callestahl/examensarbete/hardware/README.md

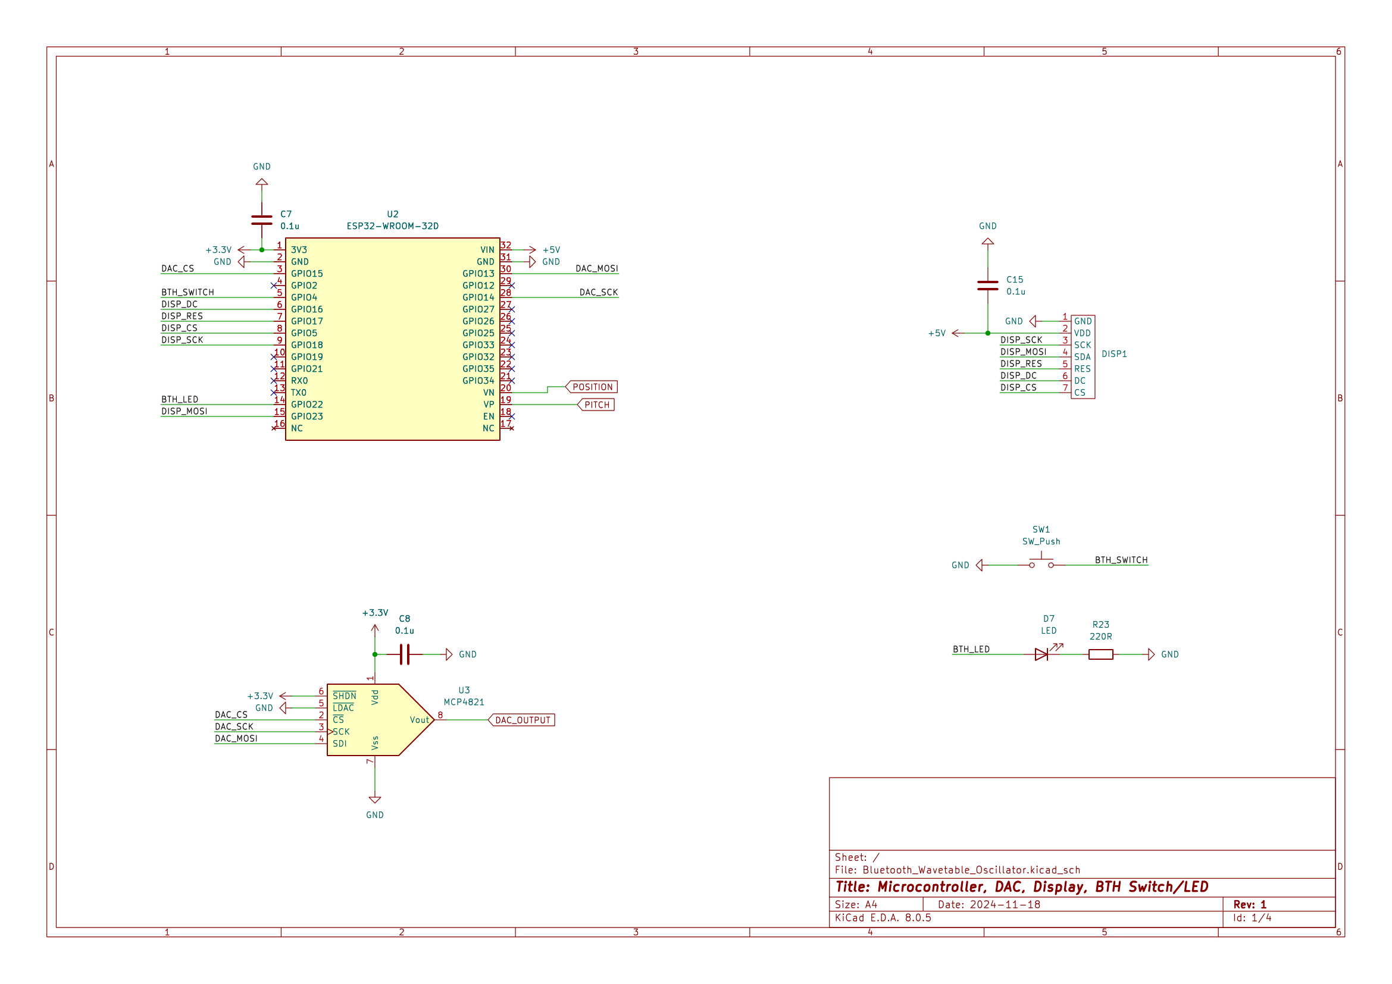
[picture p1: hardware/schematic_png/Bluetooth_Wavetable_Oscillator-1.png]

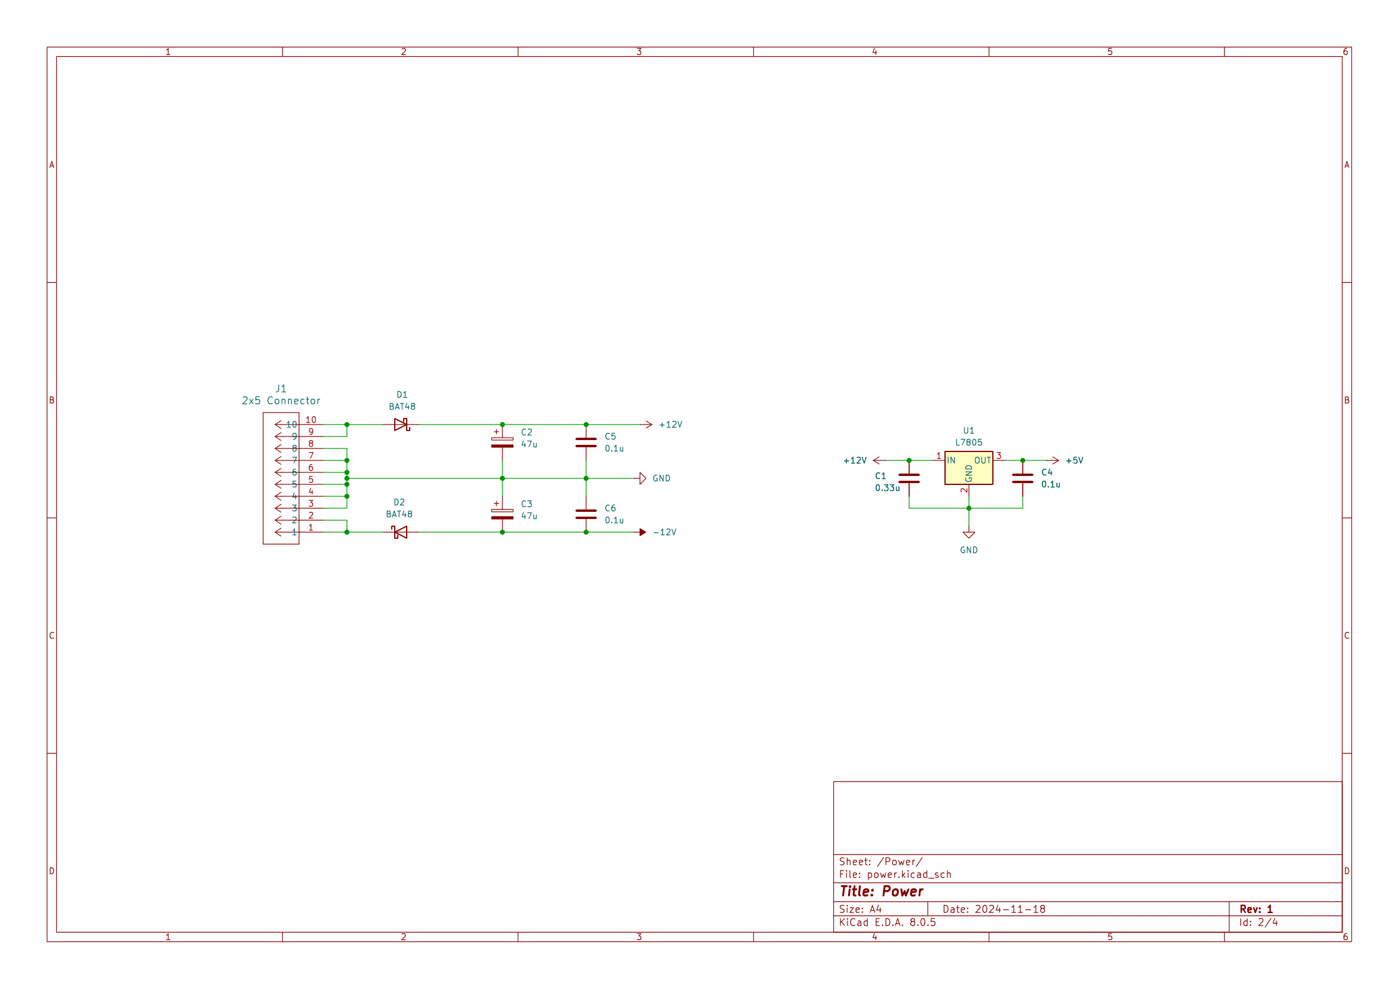
[picture p2: hardware/schematic_png/Bluetooth_Wavetable_Oscillator-2.png]

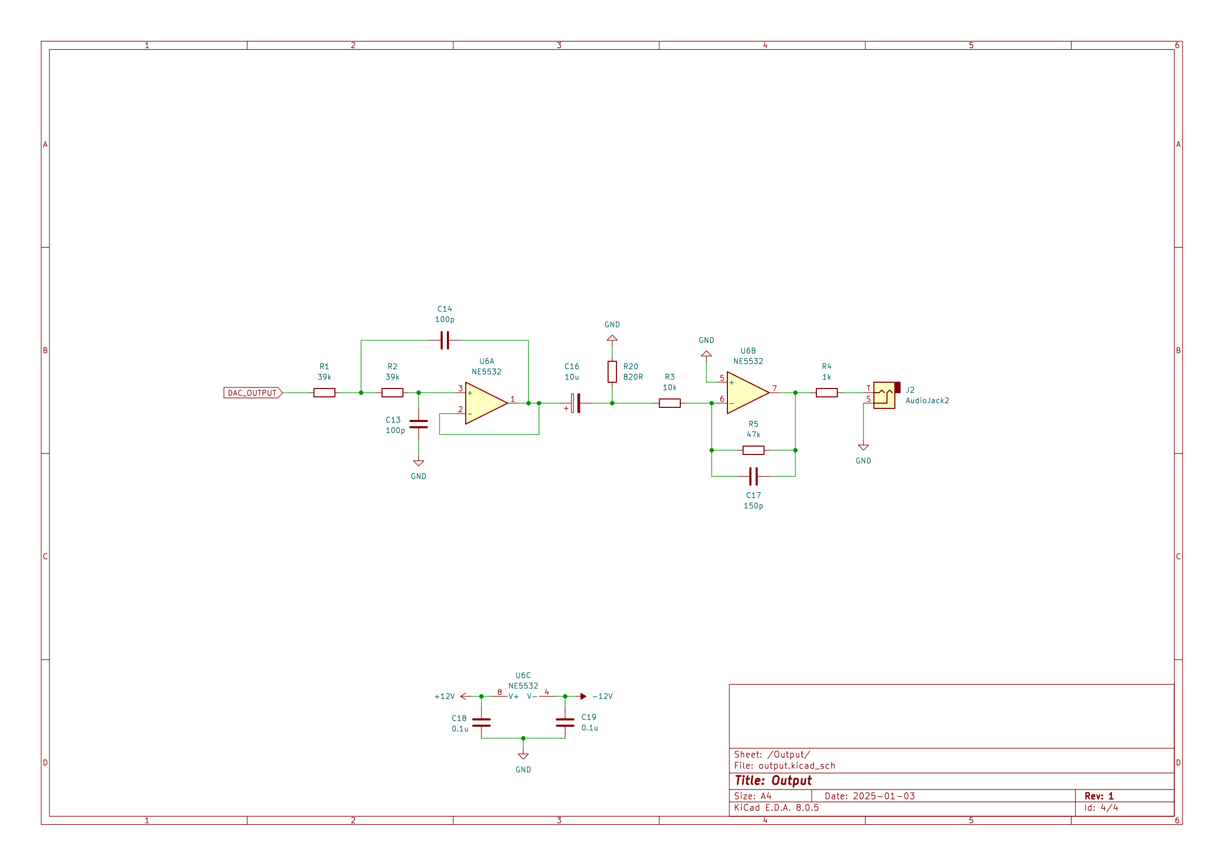
[picture p3: hardware/schematic_png/Bluetooth_Wavetable_Oscillator-3.png]

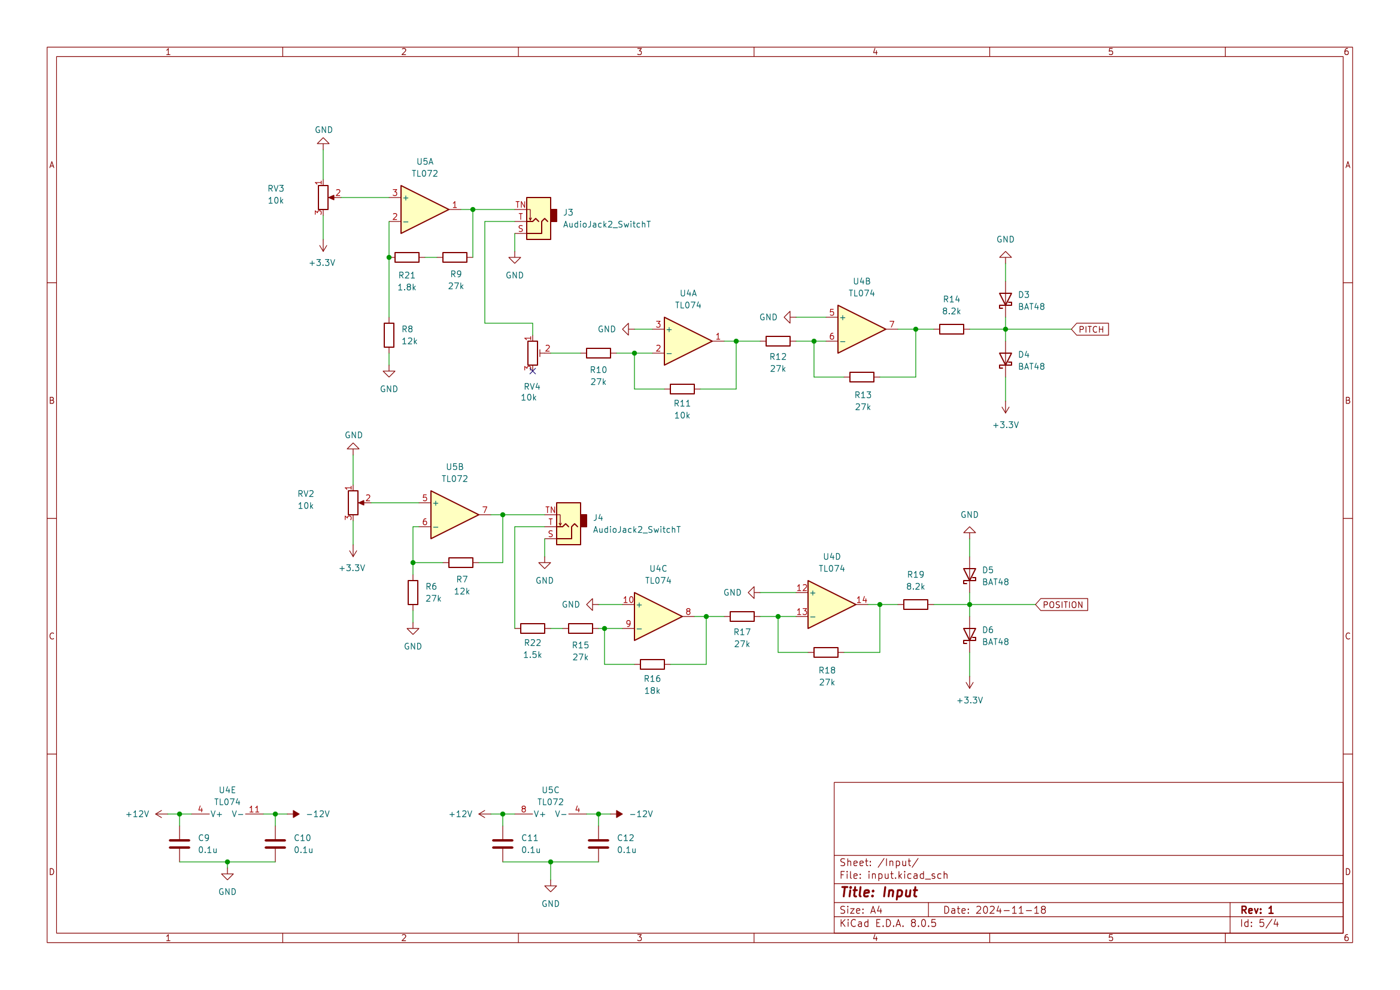
[picture p4: hardware/schematic_png/Bluetooth_Wavetable_Oscillator-4.png]
