callestahl/examensarbete/hardware/Bluetooth_Wavetable_Oscillator.pdf

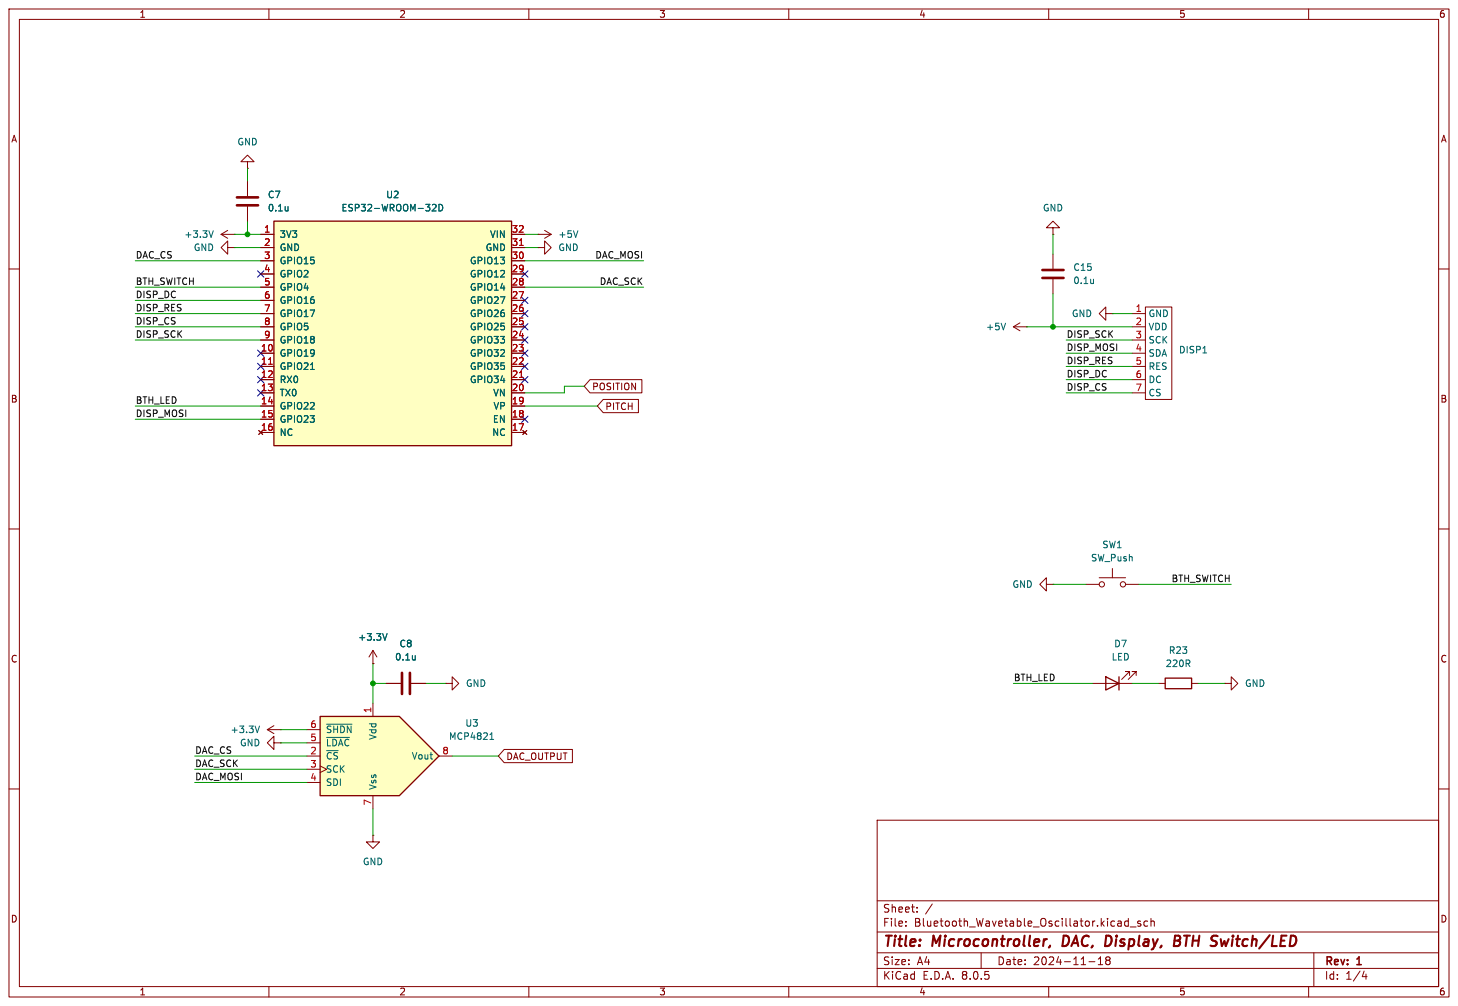
[picture p5: page 1]

Output File: output.kicad_sch GND

1 ~{CS} 2 SCK 3 SDI 4 ~{LDAC} 5 ~{SHDN} 6 Vss 7 Vout 8 U3 MCP4821 GND

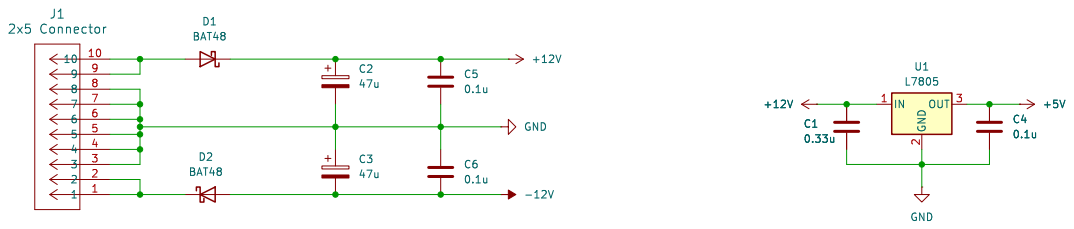
[picture p6: page 2]

Id: 2/4 Title: Power File: power.kicad_sch Sheet: /Power/

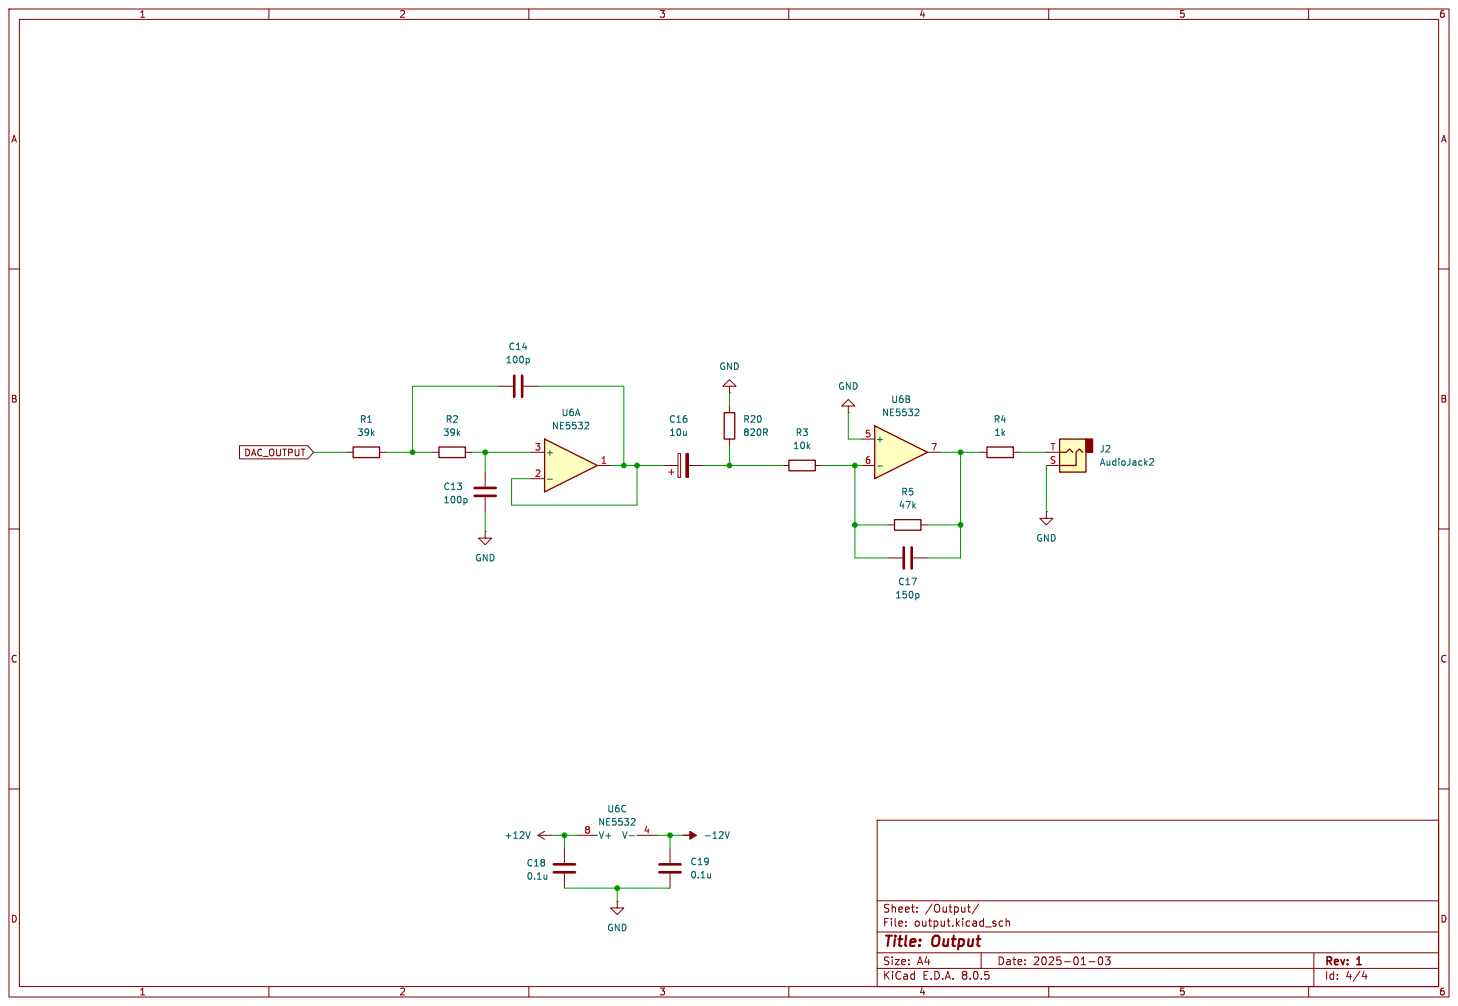
[picture p7: page 3]

Id: 4/4 Title: Output File: output.kicad_sch Sheet: /Output/

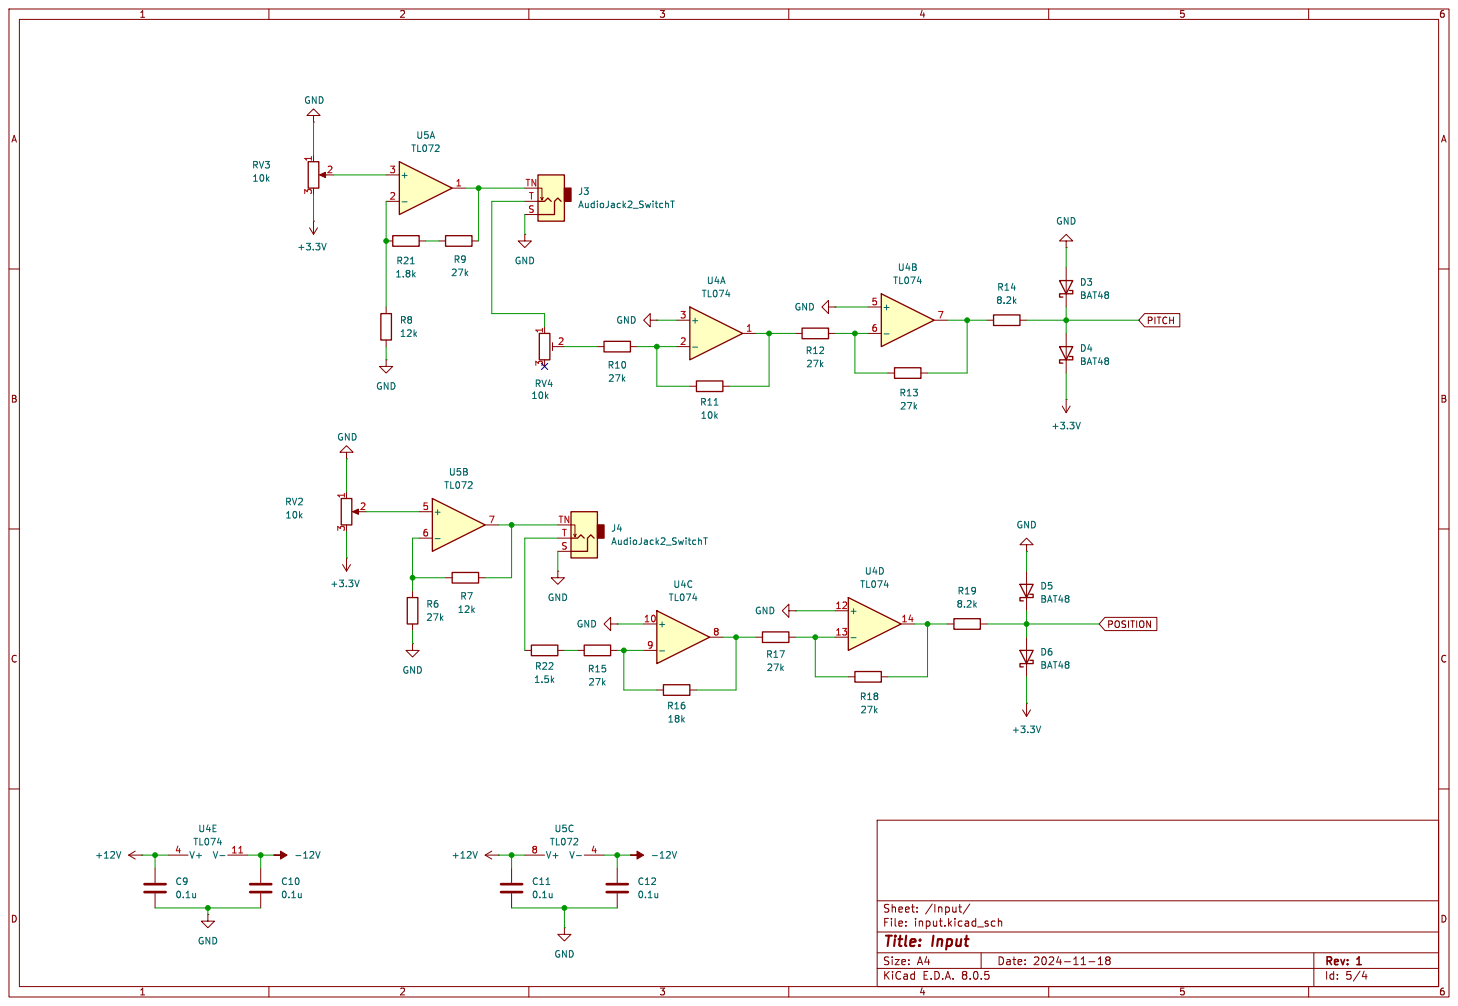
[picture p8: page 4]

Id: 5/4 Title: Input File: input.kicad_sch Sheet: /Input/ C9
