callestahl/examensarbete/hardware/Bluetooth_Wavetable_Oscillator/Bluetooth_Wavetable_Oscillator.kicad_pcb

## KiCad design hardware/Bluetooth_Wavetable_Oscillator/Bluetooth_Wavetable_Oscillator.kicad_pcb (2024-12-09)

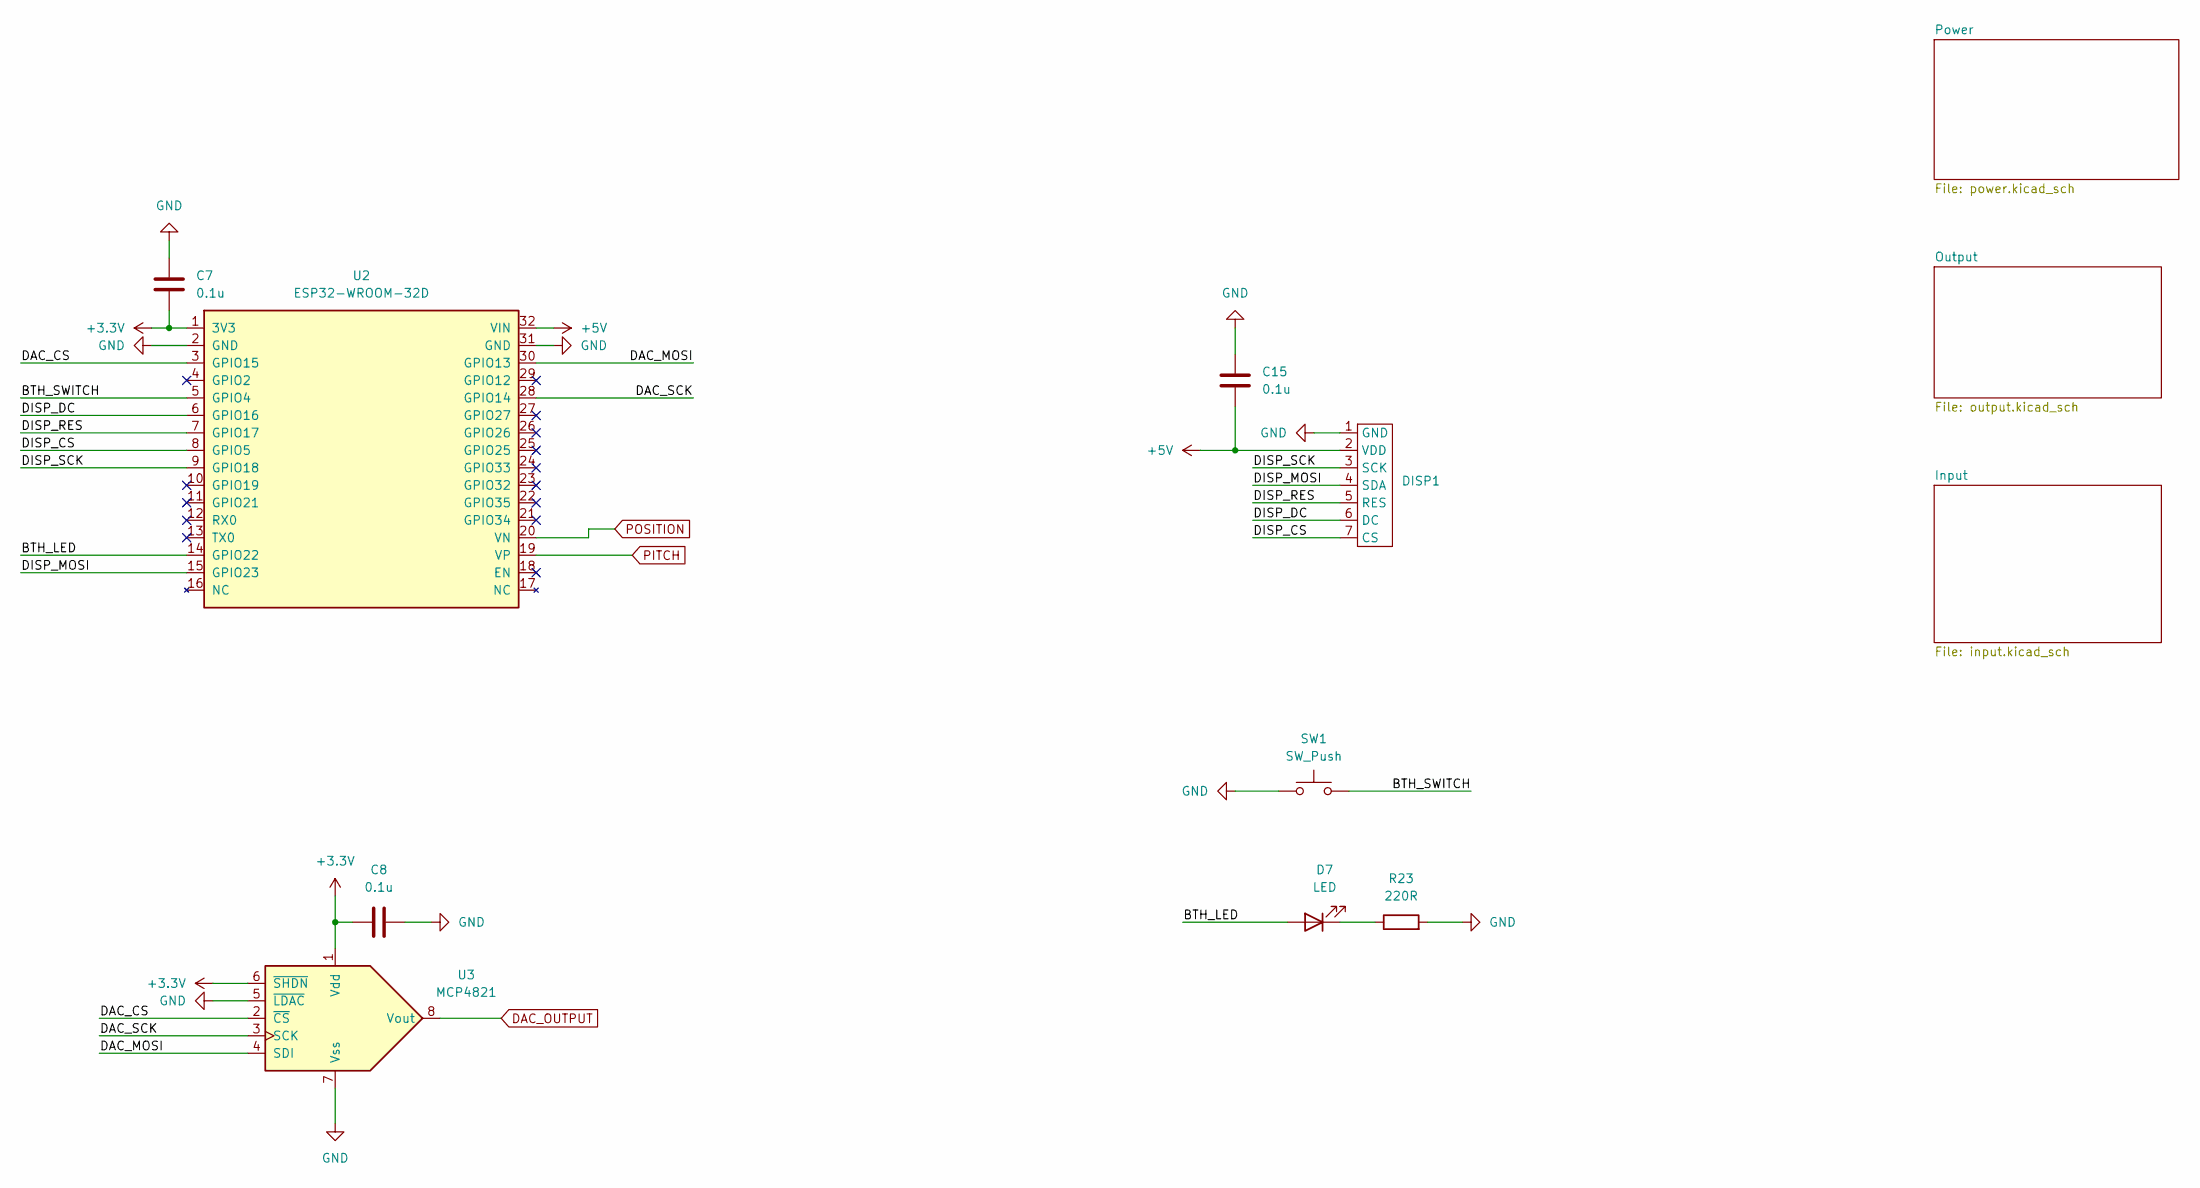
[picture p9: schematic Bluetooth_Wavetable_Oscillator.kicad_sch, Microcontroller, DAC, Display, BTH Switch/LED]

Parts:
C7, C8, C15: 0.1u; C_Disc_D5.0mm_W2.5mm_P5.00mm
D7: LED; D_A-405_P2.54mm_Vertical_AnodeUp
DISP1: 1.5inch_RGB_OLED_Module
R23: 220R; R_Axial_DIN0204_L3.6mm_D1.6mm_P2.54mm_Vertical
SW1: SW_Push; 6Pin-Switch-Button
U2: ESP32-WROOM-32D; ESP32
U3: MCP4821; DIP-8_W7.62mm

Connections:
+3.3V: C7.2, C8.1, U2.1 (3V3), U3.1 (Vdd), U3.6 (~SHDN); also elsewhere on the board
+5V: C15.2, DISP1.2 (VDD), U2.32 (VIN); also elsewhere on the board
/BTH_LED: D7.2 (A), U2.14 (GPIO22)
/BTH_SWITCH: SW1.2, U2.5 (GPIO4)
/DAC_CS: U2.3 (GPIO15), U3.2 (~CS)
/DAC_MOSI: U2.30 (GPIO13), U3.4 (SDI)
/DAC_SCK: U2.28 (GPIO14), U3.3 (SCK)
/DISP_CS: DISP1.7 (CS), U2.8 (GPIO5)
/DISP_DC: DISP1.6 (DC), U2.6 (GPIO16)
/DISP_MOSI: DISP1.4 (SDA), U2.15 (GPIO23)
/DISP_RES: DISP1.5 (RES), U2.7 (GPIO17)
/DISP_SCK: DISP1.3 (SCK), U2.9 (GPIO18)
DAC_OUTPUT: U3.8 (Vout); also elsewhere on the board
GND: C7.1, C8.2, C15.1, DISP1.1 (GND), R23.2, SW1.1, U2.2 (GND), U2.31 (GND), U3.5 (~LDAC), U3.7 (Vss); also elsewhere on the board
unnamed: D7.1 (K), R23.1
PITCH: U2.19 (VP); also elsewhere on the board
POSITION: U2.20 (VN); also elsewhere on the board

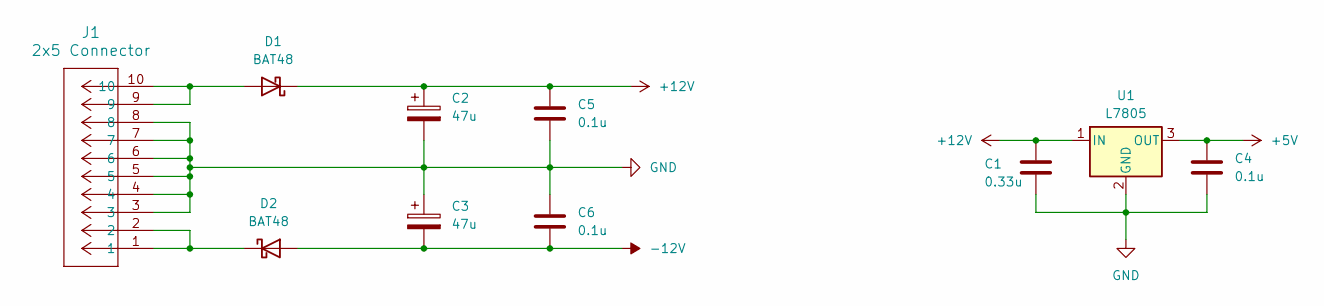
[picture p10: schematic power.kicad_sch]

Parts:
C1: 0.33u; C_Disc_D5.0mm_W2.5mm_P5.00mm
C2, C3: 47u; CP_Radial_D5.0mm_P2.50mm
C4, C5, C6: 0.1u; C_Disc_D5.0mm_W2.5mm_P5.00mm
D1, D2: BAT48; D_DO-35_SOD27_P2.54mm_Vertical_KathodeUp
J1: 2x5 Connector; 10_pin_eurorack_connector
U1: L7805; TO-220-3_Horizontal_TabDown

Connections:
+5V: C4.1, U1.3 (OUT); also elsewhere on the board
+12V: C1.1, C2.1, C5.1, D1.1 (K), U1.1 (IN); also elsewhere on the board
-12V: C3.2, C6.2, D2.2 (A); also elsewhere on the board
GND: C1.2, C2.2, C3.1, C4.2, C5.2, C6.1, J1.3, J1.4, J1.5, J1.6, J1.7, J1.8, U1.2 (GND); also elsewhere on the board
unnamed: D1.2 (A), J1.9, J1.10
unnamed: D2.1 (K), J1.1, J1.2

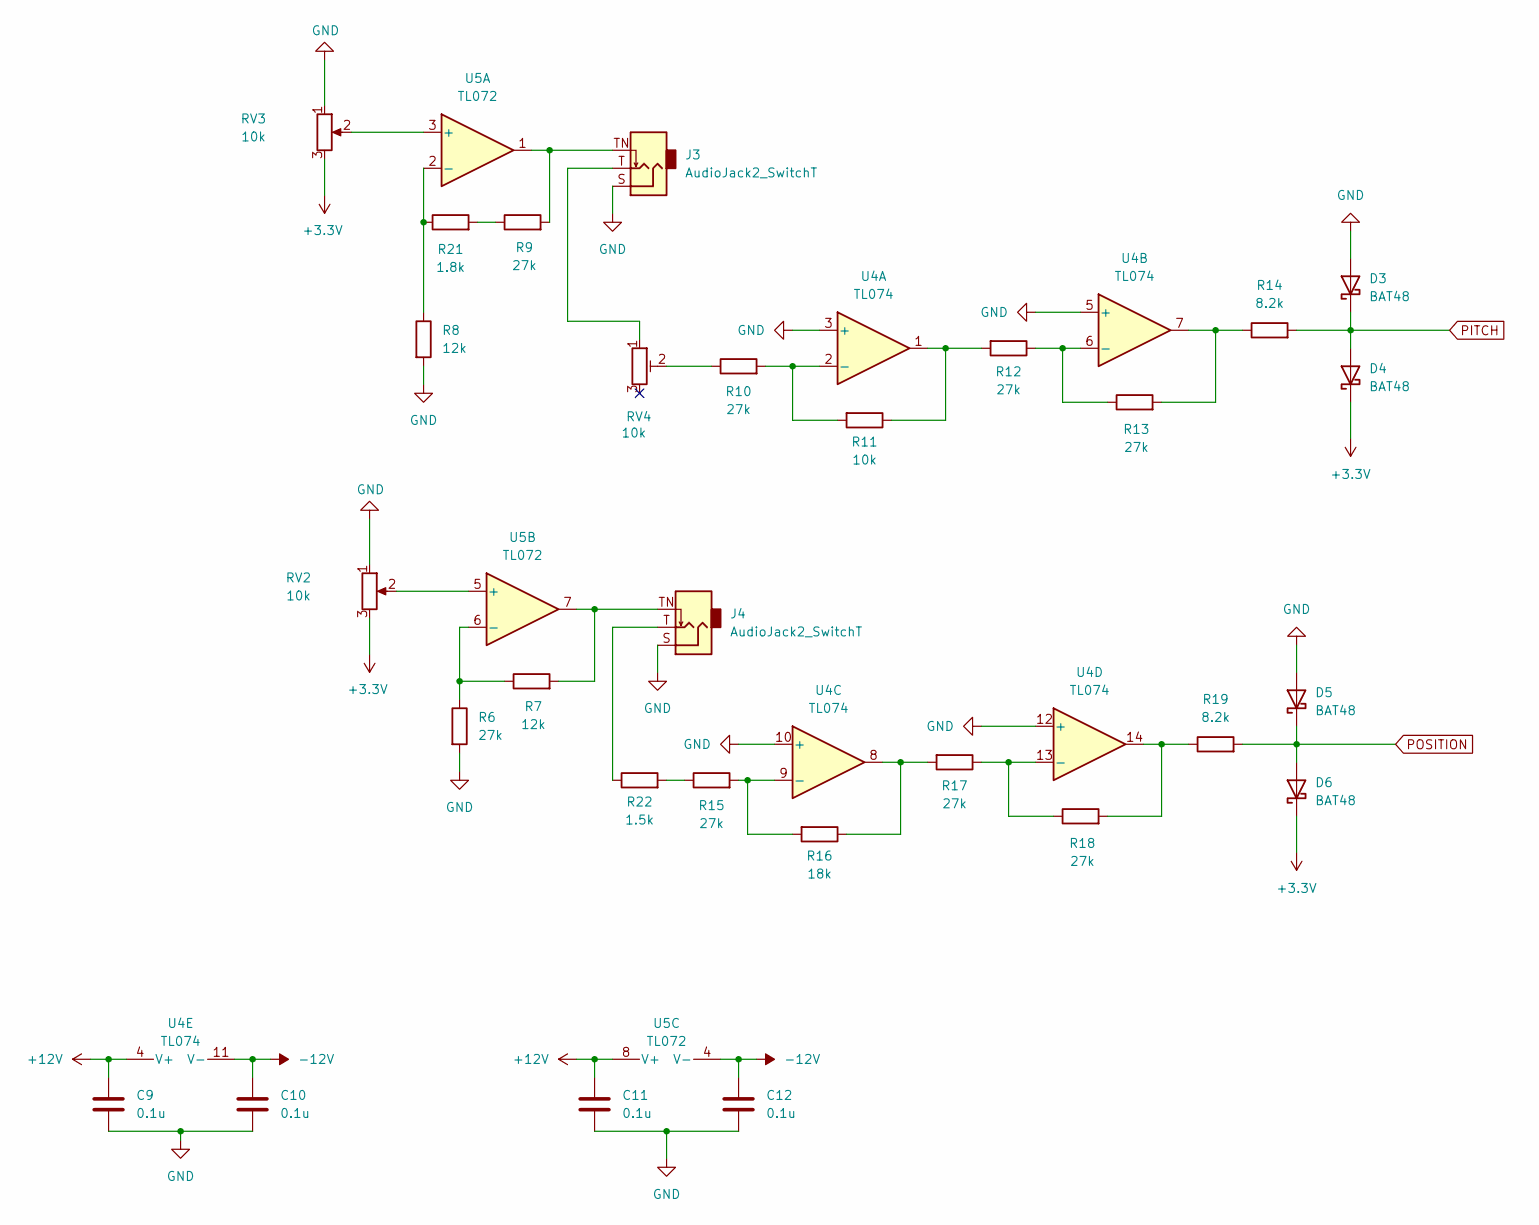
[picture p11: schematic input.kicad_sch]

Parts:
C9, C10, C11, C12: 0.1u; C_Disc_D5.0mm_W2.5mm_P5.00mm
D3, D4, D5, D6: BAT48; D_DO-34_SOD68_P7.62mm_Horizontal
J3, J4: AudioJack2_SwitchT; Jack_3.5mm_QingPu_WQP-PJ398SM_Vertical_CircularHoles
R6: 27k; R_Axial_DIN0204_L3.6mm_D1.6mm_P7.62mm_Horizontal
R7: 12k; R_Axial_DIN0204_L3.6mm_D1.6mm_P7.62mm_Horizontal
R8: 12k; R_Axial_DIN0204_L3.6mm_D1.6mm_P2.54mm_Vertical
R9, R10, R12, R13, R15, R17, R18: 27k; R_Axial_DIN0204_L3.6mm_D1.6mm_P2.54mm_Vertical
R11: 10k; R_Axial_DIN0204_L3.6mm_D1.6mm_P2.54mm_Vertical
R14, R19: 8.2k; R_Axial_DIN0204_L3.6mm_D1.6mm_P2.54mm_Vertical
R16: 18k; R_Axial_DIN0204_L3.6mm_D1.6mm_P2.54mm_Vertical
R21: 1.8k; R_Axial_DIN0204_L3.6mm_D1.6mm_P2.54mm_Vertical
R22: 1.5k; R_Axial_DIN0204_L3.6mm_D1.6mm_P2.54mm_Vertical
RV2, RV3: 10k; Potentiometer_Bourns_PTV09A-1_Single_Vertical
RV4: 10k; Trimmer-potentiometer
U4: TL074; DIP-14_W7.62mm
U5: TL072; DIP-8_W7.62mm

Connections:
+3.3V: D4.1 (K), D6.1 (K), RV2.3, RV3.3; also elsewhere on the board
+12V: C9.1, C11.1, U4.4 (V+), U5.8 (V+); also elsewhere on the board
-12V: C10.1, C12.1, U4.11 (V-), U5.4 (V-); also elsewhere on the board
GND: C9.2, C10.2, C11.2, C12.2, D3.2 (A), D5.2 (A), J3.S, J4.S, R6.2, R8.2, RV2.1, RV3.1, U4.3 (+), U4.5 (+), U4.10 (+), U4.12 (+); also elsewhere on the board
unnamed: J3.T, RV4.1
unnamed: J3.TN, R9.2, U5.1
unnamed: J4.T, R22.1
unnamed: J4.TN, R7.2, U5.7
unnamed: R10.1, RV4.2
unnamed: R11.1, R12.2, U4.1
unnamed: R13.2, R14.1, U4.7
unnamed: R15.1, R22.2
unnamed: R16.1, R17.2, U4.8
unnamed: R18.2, R19.1, U4.14
unnamed: R9.1, R21.2
unnamed: R10.2, R11.2, U4.2 (-)
unnamed: R12.1, R13.1, U4.6 (-)
unnamed: R15.2, R16.2, U4.9 (-)
unnamed: R17.1, R18.1, U4.13 (-)
unnamed: RV3.2, U5.3 (+)
unnamed: R8.1, R21.1, U5.2 (-)
unnamed: RV2.2, U5.5 (+)
unnamed: R6.1, R7.1, U5.6 (-)
PITCH: D3.1 (K), D4.2 (A), R14.2; also elsewhere on the board
POSITION: D5.1 (K), D6.2 (A), R19.2; also elsewhere on the board

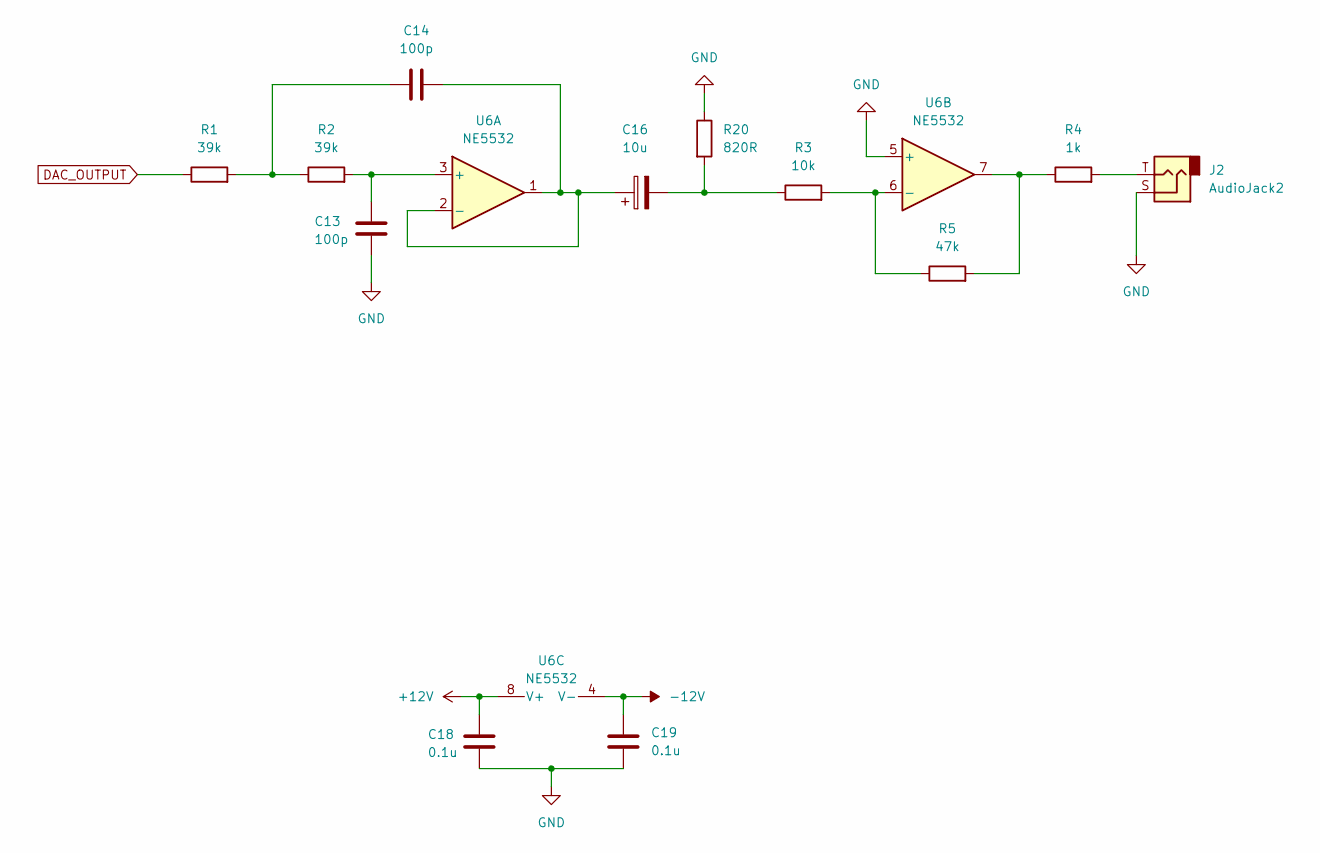
[picture p12: schematic output.kicad_sch]

Parts:
C13, C14: 100p; C_Disc_D5.0mm_W2.5mm_P5.00mm
C16: 10u; CP_Radial_D5.0mm_P2.50mm
C18, C19: 0.1u; C_Disc_D5.0mm_W2.5mm_P5.00mm
J2: AudioJack2; Jack_3.5mm_QingPu_WQP-PJ398SM_Vertical_CircularHoles
R1, R2: 39k; R_Axial_DIN0204_L3.6mm_D1.6mm_P7.62mm_Horizontal
R3: 10k; R_Axial_DIN0204_L3.6mm_D1.6mm_P7.62mm_Horizontal
R4: 1k; R_Axial_DIN0204_L3.6mm_D1.6mm_P7.62mm_Horizontal
R5: 47k; R_Axial_DIN0204_L3.6mm_D1.6mm_P7.62mm_Horizontal
R20: 820R; R_Axial_DIN0204_L3.6mm_D1.6mm_P7.62mm_Horizontal
U6: NE5532; DIP-8_W7.62mm

Connections:
+12V: C18.1, U6.8 (V+); also elsewhere on the board
-12V: C19.1, U6.4 (V-); also elsewhere on the board
DAC_OUTPUT: R1.1; also elsewhere on the board
GND: C13.2, C18.2, C19.2, J2.S, R20.1, U6.5 (+); also elsewhere on the board
unnamed: C14.2, R1.2, R2.1
unnamed: C16.2, R3.1, R20.2
unnamed: J2.T, R4.2
unnamed: R4.1, R5.2, U6.7
unnamed: C13.1, R2.2, U6.3 (+)
unnamed: C14.1, C16.1, U6.1, U6.2 (-)
unnamed: R3.2, R5.1, U6.6 (-)

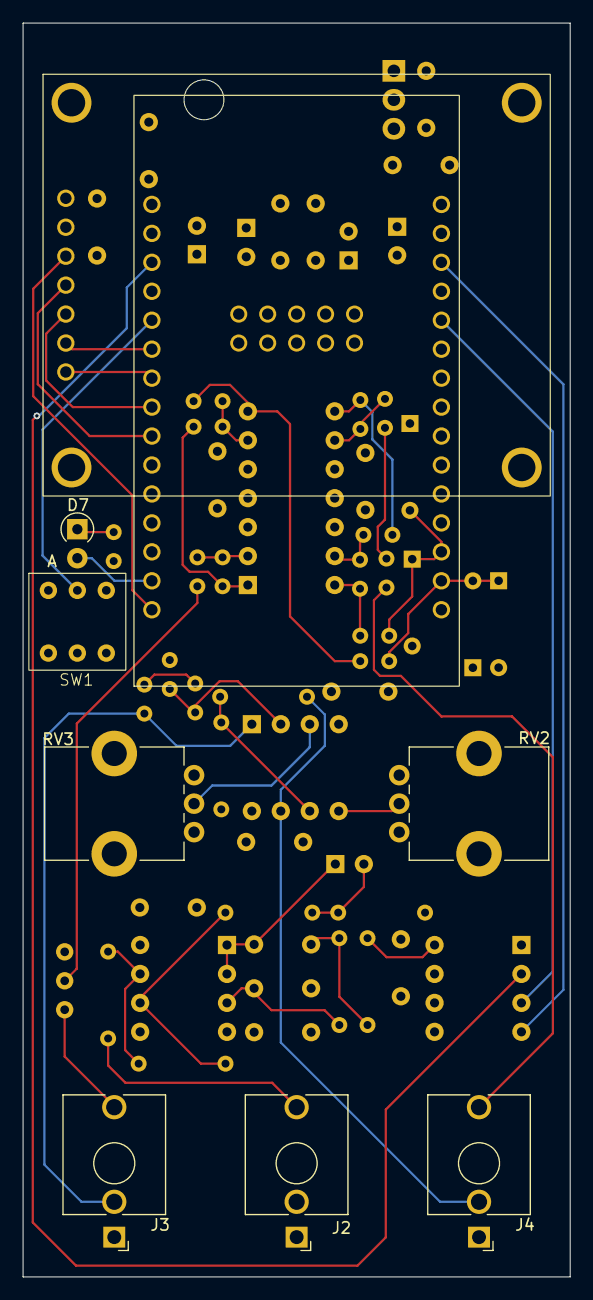
[picture p13: board Bluetooth_Wavetable_Oscillator.kicad_pcb from above]

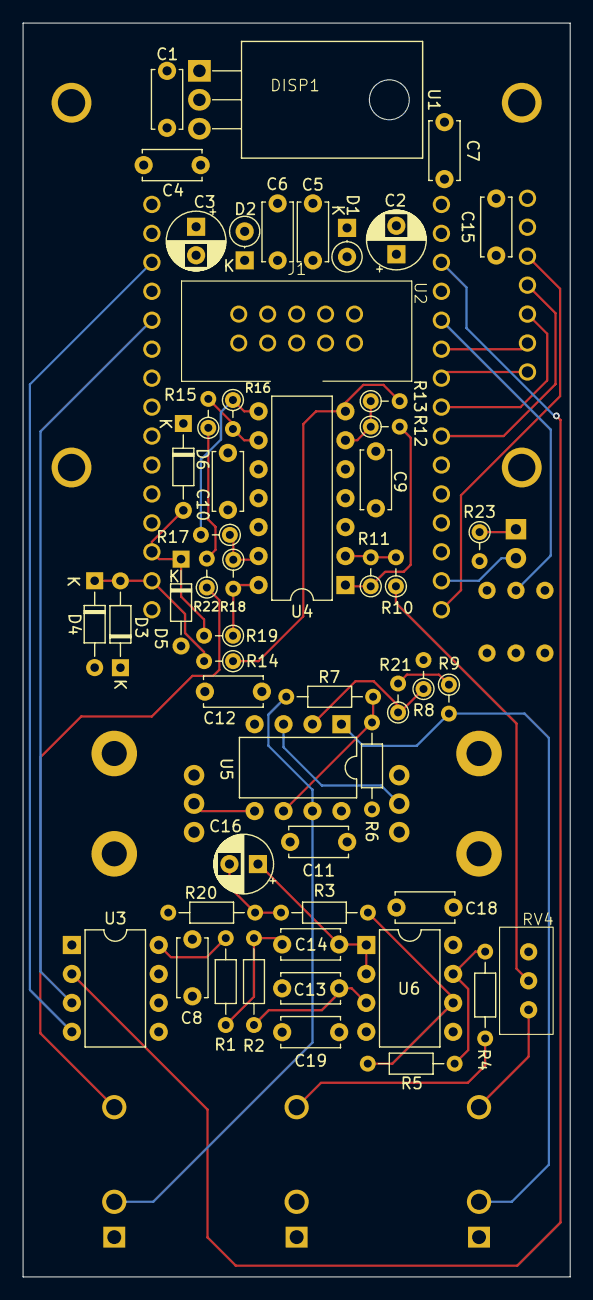
[picture p14: board Bluetooth_Wavetable_Oscillator.kicad_pcb from below]

Board: 4 copper layers, 48.0 x 110.0 mm, 63 parts (54 on the bottom side), 47 nets.
