callestahl/examensarbete/esp32/spp_application/spp.cpp

#include "spp.h"
#include "define.h"
#include "bluetooth.h"

#include "BluetoothSerial.h"
#include <Adafruit_GFX.h>
#include <Adafruit_SSD1351.h>

#define BLUETOOTH_FINISHED_CODE 0x06
#define BLUETOOTH_ACKNOWLEDGE_CODE 0x08
#define BLUETOOTH_ERROR_CODE 0x10

struct BluetoothHeader
{
    uint16_t id0;
    uint16_t id1;
    uint16_t id2;
    uint16_t id3;
    uint16_t cycle_sample_count;
    uint16_t total_bytes_to_receive_high;
    uint16_t total_bytes_to_receive_low;
};

struct SPP
{
    BluetoothSerial bluetooth_serial;
    Bluetooth bluetooth;
    QueueHandle_t queue;
    TaskHandle_t* task_notification_handle;

    bool initialized;
    uint32_t bytes_received;
    uint32_t bytes_to_received;
    uint32_t queue_size;
    uint64_t last_read_value_time;
    uint64_t time_before_reset;
};

global WaveTableOscillator* g_temp_osci = NULL;
global SPP g_spp;
global uint32_t g_chunk_bytes = 0;

internal uint8_t spp_read(void)
{
    uint8_t value = 0;
    if (xQueueReceive(g_spp.queue, &value, 0))
    {
        return value;
    }
    return 0;
}

internal int spp_data_in_queue(void)
{
    return uxQueueMessagesWaiting(g_spp.queue);
}

internal void spp_clear_queue()
{
    while (spp_data_in_queue())
    {
        spp_read();
    }
}

internal bool spp_has_timed_out(uint64_t start_time, uint64_t time_to_timeout)
{
    if ((millis() - start_time) > time_to_timeout)
    {
        g_chunk_bytes = 0;
        g_spp.bytes_received = 0;
        g_spp.bytes_to_received = 0;
        bluetooth_reset(&g_spp.bluetooth);
        spp_clear_queue();
        g_spp.bluetooth_serial.write(BLUETOOTH_ERROR_CODE);
        return true;
    }
    return false;
}

internal uint16_t spp_get_uint16()
{
    g_chunk_bytes += 2;
    g_spp.bytes_received += 2;
    uint8_t high = spp_read();
    uint8_t low = spp_read();
    return ((uint16_t)high << 8) | ((uint16_t)low);
}

internal void spp_revert_transaction()
{
    g_chunk_bytes = 0;
    g_spp.bytes_received = 0;
    g_spp.bytes_to_received = 0;
    bluetooth_reset(&g_spp.bluetooth);
    spp_clear_queue();
    g_spp.bluetooth_serial.write(BLUETOOTH_ERROR_CODE);
}

internal bool spp_read_header()
{
    g_chunk_bytes = 0;
    g_spp.bytes_received = 0;
    uint16_t id0 = spp_get_uint16();
    uint16_t id1 = spp_get_uint16();
    uint16_t id2 = spp_get_uint16();
    uint16_t id3 = spp_get_uint16();
    if (id0 == 29960 && id1 == 62903 && id2 == 35185 && id3 == 26662)
    {
        uint16_t cycle_sample_count = spp_get_uint16();
        if (g_temp_osci->total_cycles)
        {
            wave_table_oscilator_clean(g_temp_osci);
        }
        g_temp_osci->samples_per_cycle = cycle_sample_count;
        g_temp_osci->total_cycles = 0;
        g_spp.bluetooth.header_read = true;
        g_spp.bluetooth.table_index = 0;
        g_spp.bluetooth.sample_index = 0;

        uint16_t bytes_to_received_high = spp_get_uint16();
        uint16_t bytes_to_received_low = spp_get_uint16();
        g_spp.bytes_to_received = ((uint32_t)bytes_to_received_high << 16) |
                                  (uint32_t)bytes_to_received_low;

        // g_spp.bluetooth_serial.write(BLUETOOTH_ACKNOWLEDGE_CODE);
    }
    else
    {
        spp_revert_transaction();
        return false;
    }
    return true;
}

internal uint16_t spp_sample_key(uint16_t key)
{
    key = ~key + (key << 15);
    key = key ^ (key >> 12);
    key = key + (key << 2);
    key = key ^ (key >> 4);
    key = key * 2057;
    key = key ^ (key >> 16);
    return key;
}

global uint32_t te = 0;

internal bool spp_process_sample()
{
    // uint16_t key = spp_get_uint16();
    uint16_t sample = spp_get_uint16();
    // if (key == spp_sample_key(sample))
    {
        BluetoothSampleProcessCode code =
            bluetooth_process_sample(&g_spp.bluetooth, sample, g_temp_osci);
        if (code == SAMPLE_PROCESS_ERROR)
        {
            return false;
        }
        else if (g_chunk_bytes == g_spp.queue_size)
        {
            g_spp.bluetooth_serial.write(BLUETOOTH_ACKNOWLEDGE_CODE);
            g_chunk_bytes = 0;
        }
        return true;
    }
    // return false;
}

void on_spp_data_receive_cb(const uint8_t* data, size_t size)
{
    for (size_t i = 0; i < size; ++i)
    {
        xQueueSend(g_spp.queue, data + i, (TickType_t)0);
    }
    if (*g_spp.task_notification_handle != NULL)
    {
        xTaskNotifyGive(*g_spp.task_notification_handle);
    }
}

void spp_setup(TaskHandle_t* task_notification_handle, uint32_t queue_size)
{
    if (!g_spp.initialized)
    {
        g_spp.task_notification_handle = task_notification_handle;
        g_spp.queue_size = queue_size;
        g_spp.queue = xQueueCreate(queue_size, sizeof(uint8_t));
        g_spp.initialized = true;
        g_spp.time_before_reset = 500;
#if 0
        g_temp_osci.tables_capacity = 256;
        g_temp_osci.tables =
            (WaveTable*)calloc(g_temp_osci.tables_capacity, sizeof(WaveTable));
#endif
    }
    else
    {
        // TODO(Linus): Logging
    }
}

void spp_begin(const char* name)
{
    g_spp.bluetooth_serial.begin(name, false, true);
    g_spp.bluetooth_serial.enableSSP();
    g_spp.bluetooth_serial.onData(on_spp_data_receive_cb);
}

void spp_end(void)
{
    g_spp.bluetooth_serial.end();
    g_spp.bluetooth_serial.disableSSP();
}

BluetoothCode spp_is_complete()
{

    if (g_spp.bluetooth.reading_samples)
    {
        if (spp_has_timed_out(g_spp.last_read_value_time,
                              g_spp.time_before_reset))
        {
            return BLUETOOTH_ERROR;
        }
        if (g_spp.bytes_received == g_spp.bytes_to_received)
        {
            g_chunk_bytes = 0;
            g_spp.bytes_received = 0;
            g_spp.bytes_to_received = 0;
            bluetooth_reset(&g_spp.bluetooth);
            g_spp.bluetooth_serial.write(BLUETOOTH_FINISHED_CODE);
            if (g_temp_osci->total_cycles > 0)
            {
#if 0
                if (xSemaphoreTake(mutex, portMAX_DELAY))
                {
                    if (xSemaphoreTake(mutex_screen, portMAX_DELAY))
                    {
                        wave_table_oscilator_clean(oscillator);
                        WaveTableOscillator temp = *oscillator;
                        *oscillator = g_temp_osci;
                        g_temp_osci = temp;
                        xSemaphoreGive(mutex_screen);
                    }
                    xSemaphoreGive(mutex);
                }
#endif
                return BLUETOOTH_DONE;
            }
        }
    }
    return BLUETOOTH_OK;
}

BluetoothCode spp_look_for_incoming_messages(WaveTableOscillator* oscillator)

{
    const uint64_t start_time = millis();
    const uint64_t time_to_timeout = 500;

    g_temp_osci = oscillator;

    while (spp_data_in_queue())
    {
        if (spp_has_timed_out(start_time, time_to_timeout))
        {
            return BLUETOOTH_ERROR;
        }
        if (!g_spp.bluetooth.header_read)
        {
            if (spp_data_in_queue() >= sizeof(BluetoothHeader))
            {
                if (!spp_read_header())
                {
                    return BLUETOOTH_ERROR;
                }
            }
        }
        else
        {
            if (spp_data_in_queue() >= 2)
            {
                if (!spp_process_sample())
                {
                    spp_revert_transaction();
                    return BLUETOOTH_ERROR;
                }
            }
            g_spp.bluetooth.reading_samples = true;
        }
        g_spp.last_read_value_time = millis();
    }
    return spp_is_complete();
}
