callestahl/examensarbete/(commit log)

2024-11-06 Ported code from pico to esp32
2024-11-07 add analog to pitch function
2024-11-08 Skuff impl, cycle sample count calculation
2024-11-09 Cycles to device bluetooth logic working
2024-11-14 More refactoring and bug fix
    [application.cpp, spp.cpp, wave_table.cpp]
2024-11-14 add kicad project
    [Bluetooth_Wavetable_Oscillator.kicad_pcb, Bluetooth_Wavetable_Oscillator.kicad_sch]
2024-11-18 first schematic
    [Bluetooth_Wavetable_Oscillator.kicad_pcb, Bluetooth_Wavetable_Oscillator.kicad_sch, input.kicad_sch, output.kicad_sch, power.kicad_sch]
2024-11-21 bluetooth logic in seperate task, mutex on oscillator writes, notify task to run
    [application.cpp, main.cpp, spp.cpp, spp.h]
2024-11-22 comment out buggy algorithm
    [application.cpp, audio_processing.cpp, audio_processing.h, main.cpp, spp.cpp, spp.h]
2024-11-25 add audio test files
    [Bluetooth_Wavetable_Oscillator.kicad_pcb, Bluetooth_Wavetable_Oscillator.kicad_sch, input.kicad_sch, output.kicad_sch, power.kicad_sch]
2024-11-25 change ADC input pins in schematic
    [Bluetooth_Wavetable_Oscillator.kicad_sch]
2024-11-28 add bth components, add component values, update SPI pins, change disp power supply to 5V
    [Bluetooth_Wavetable_Oscillator.kicad_sch, input.kicad_sch, output.kicad_sch, power.kicad_sch]
2024-11-28 Bluetooth on by button click
2024-11-29 start PCB layout
    [Bluetooth_Wavetable_Oscillator.kicad_pcb, Bluetooth_Wavetable_Oscillator.kicad_sch, input.kicad_sch, output.kicad_sch]
2024-11-29 add kicad libraries
    [Bluetooth_Wavetable_Oscillator.kicad_pcb]
2024-12-02 update esp32 footprint
    [Bluetooth_Wavetable_Oscillator.kicad_pcb]
2024-12-02 update shematic, PCB and footprints
    [Bluetooth_Wavetable_Oscillator.kicad_pcb, input.kicad_sch, output.kicad_sch, power.kicad_sch]
2024-12-09 all items connected
    [Bluetooth_Wavetable_Oscillator.kicad_pcb, input.kicad_sch, output.kicad_sch]
2024-12-09 fix silkscreen clipping
    [Bluetooth_Wavetable_Oscillator.kicad_pcb]
2024-12-09 passing DRC
    [Bluetooth_Wavetable_Oscillator.kicad_pcb]
2024-12-28 add Effekt
    [Sheet 1-A.csv, Sheet 1-T.csv]
2025-01-02 add feedback capacitor
    [output.kicad_sch]
2025-01-03 add schematic pngs
2025-01-04 Some changes for cleanup
    [ble_energy.csv, ble_energy.xlsx, buffer_size_71KB.xlsx, table_mean_connection.xlsx, table_mean_energy_ble.xlsx, table_mean_energy_spp.xlsx, table_mean_sd_cv.xlsx]
2025-01-10 Looking for adresses on a seperate thread on SPP for faster startup
2025-01-19 Some cleanup
    [buffer_size_71KB.xlsx, table_mean_connection.xlsx, table_mean_energy_ble.xlsx, table_mean_energy_spp.xlsx, table_mean_sd_cv.xlsx]
